wkblzmn/Cadence/firmware/cadence_cam/cadence_cam.ino

// ─────────────────────────────────────────────────────────────────────────
//  Cadence — camera board firmware
//  Target : ESP32-S3-CAM N16R8 + OV3660
//  Role   : put an MJPEG stream on the LAN, serve the page that watches it,
//           and hold the session state that decides when it records.
//
//  This board does no vision work. A browser tab does — it loads /vision from
//  here, runs MediaPipe against the stream, and POSTs focus samples back for
//  relaying. Keeping inference off the S3 is the whole reason the vision tier
//  is a separate tier; on-device vision is parked in Argus, not built here.
//
//  There is no phone in the built design, despite what the original plan said:
//  the vision host is a browser on the desktop. What matters about that is
//  that nothing records unless a tab is open, which is why the hub's Home
//  screen has a pill that can say NO VIEWER.
//
//  Pin map confirmed on hardware by 07_bringup_camera: the layout the ESP32
//  core calls ESP32S3_EYE, which is also the generic S3-CAM layout. Sensor
//  reported PID 0x3660, a genuine OV3660.
//
//  Board settings — these DIFFER from the hub, which is an N8R2:
//    ESP32S3 Dev Module · 16MB flash · **OPI PSRAM** (octal, not quad)
//    USB CDC on Boot Disabled · flash over the UART port
//
//  Credentials live in secrets.h in this folder, kept out of git.
// ─────────────────────────────────────────────────────────────────────────

#include "esp_camera.h"
#include <WiFi.h>
#include <WebServer.h>
#include <ESPmDNS.h>
#include <HTTPClient.h>
#include <WiFiClientSecure.h>
#include "secrets.h"
#include "vision_page.h"
#include "usb_stream.h"
#include "espnow_sync.h"

// ═══════════════════════════════════════════════════ pins (07_bringup_camera)

#define PIN_PWDN  -1
#define PIN_RESET -1
#define PIN_XCLK  15
#define PIN_SIOD   4
#define PIN_SIOC   5

#define PIN_D7    16
#define PIN_D6    17
#define PIN_D5    18
#define PIN_D4    12
#define PIN_D3    10
#define PIN_D2     8
#define PIN_D1     9
#define PIN_D0    11

#define PIN_VSYNC  6
#define PIN_HREF   7
#define PIN_PCLK  13

// Two servers on purpose.
//
// WebServer handles one client at a time and a streaming handler never
// returns while its viewer stays connected — so serving MJPEG from port 80
// makes the board deaf to every other request, including its own status
// page. A stale browser tab then locks everything out until a power cycle.
// Espressif's own example splits the ports for exactly this reason.
//
// Port 80: control. Always answers.
// Port 81: MJPEG, driven by its own task.
// The focus relay does a TLS handshake from inside a WebServer handler, which
// runs on the Arduino loop task. That handshake wants roughly 6 KB of stack
// and the default loop task has 8 KB — too close to rely on, and a stack
// overflow here would look like a random reboot whenever a sample is posted.
SET_LOOP_TASK_STACK_SIZE(16 * 1024);

WebServer  server(80);
WiFiServer streamServer(81);

// The single active viewer. A new connection displaces the old one rather
// than being refused: the common case is moving from the laptop to the phone,
// and being told "busy" by a tab you already closed is useless.
WiFiClient streamClient;

volatile uint32_t framesSent = 0;
volatile uint32_t lastFrameMs = 0;

// ═══════════════════════════════════════════════════ camera

// The live config is kept so the camera can be torn down and brought back up
// at a different frame size. esp_camera_init() allocates the frame buffers
// from this, which is exactly why a resolution change cannot be a simple
// set_framesize() call — see camRestart().
camera_config_t camCfg = {};

// Held around every use of a frame buffer. A reconfigure frees the buffers a
// streaming frame may still be writing into, so the two must never overlap.
SemaphoreHandle_t camLock = nullptr;

static void camConfigure(framesize_t fs) {
  camera_config_t &cfg = camCfg;
  cfg.pin_pwdn     = PIN_PWDN;
  cfg.pin_reset    = PIN_RESET;
  cfg.pin_xclk     = PIN_XCLK;
  cfg.pin_sccb_sda = PIN_SIOD;
  cfg.pin_sccb_scl = PIN_SIOC;
  cfg.pin_d7 = PIN_D7; cfg.pin_d6 = PIN_D6; cfg.pin_d5 = PIN_D5; cfg.pin_d4 = PIN_D4;
  cfg.pin_d3 = PIN_D3; cfg.pin_d2 = PIN_D2; cfg.pin_d1 = PIN_D1; cfg.pin_d0 = PIN_D0;
  cfg.pin_vsync = PIN_VSYNC;
  cfg.pin_href  = PIN_HREF;
  cfg.pin_pclk  = PIN_PCLK;

  cfg.xclk_freq_hz = 20000000;
  cfg.ledc_timer   = LEDC_TIMER_0;
  cfg.ledc_channel = LEDC_CHANNEL_0;

  // VGA, and deliberately not higher. MediaPipe's face pipeline downscales
  // its input to a few hundred pixels square before inference — a detector
  // crop feeding a landmark model — so resolution above roughly VGA is
  // discarded by the consumer before it is looked at. Measured on this board:
  // XGA is no faster and no more useful, it is just more bytes.
  //
  // Below VGA is worse, not better. QVGA and CIF measured ZERO frames: this
  // is a 3MP sensor and small sizes engage a scaler path that stalls. On this
  // part, asking for less is asking for slower.
  //
  // Quality 8 rather than 12: bandwidth peaked at 0.5 Mbps across every
  // configuration tested, so there is nothing to save by compressing harder,
  // and JPEG blocking costs exactly the fine structure a landmarker uses.
  cfg.pixel_format = PIXFORMAT_JPEG;
  cfg.frame_size   = fs;
  cfg.jpeg_quality = 8;
  cfg.fb_count     = 2;
  cfg.fb_location  = CAMERA_FB_IN_PSRAM;
  // LATEST, not WHEN_EMPTY: a viewer that falls behind should skip frames
  // rather than watch an ever-growing lag. Gaze data that is three seconds
  // late is worse than no data.
  cfg.grab_mode    = CAMERA_GRAB_LATEST;
}

static bool camStart() {
  esp_err_t err = esp_camera_init(&camCfg);
  if (err != ESP_OK) {
    Serial.printf("FATAL: camera init failed (0x%04x %s)\n", err, esp_err_to_name(err));
    return false;
  }

  sensor_t *s = esp_camera_sensor_get();
  Serial.printf("Camera  : ok, sensor PID 0x%04X\n", s ? s->id.PID : 0);

  // OV3660-specific correction, as in Espressif's own example: this sensor
  // comes up vertically flipped and over-saturated.
  if (s && s->id.PID == OV3660_PID) {
    s->set_vflip(s, 1);
    s->set_brightness(s, 1);
    s->set_saturation(s, -2);
  }

  // Favour frame rate over exposure from the start. This device lives on a
  // desk that is often dim — the light sensor next door has been reporting
  // single-digit lux — and left to itself the sensor lengthens exposure until
  // the stream drops to a few frames a second. Gain is the cheaper currency
  // here: the model wants a current frame more than a clean one. Reversible
  // at runtime with /set?fast=0.
  if (s) {
    // Low-light configuration, on by default, because a dim desk in the
    // evening is the case this device exists for. Verified on hardware: at
    // ~30 lux the auto loops give a black frame, and this gives a clearly
    // landmarkable face.
    //
    // The reason auto could never get there: aec_value and agc_gain are
    // manual-mode registers, ignored entirely while exposure_ctrl and
    // gain_ctrl are on auto. Raising ceilings and targets did nothing because
    // the sensor's own loop was overriding all of it.
    //
    // The trade is that manual exposure does not adapt, so a bright room will
    // blow this out. /set?night=0 hands both loops back to auto.
    s->set_gainceiling(s, GAINCEILING_128X);
    s->set_exposure_ctrl(s, 0);
    s->set_aec_value(s, 700);
    s->set_gain_ctrl(s, 0);
    s->set_agc_gain(s, 20);
    s->set_ae_level(s, 2);
    s->set_brightness(s, 2);
    s->set_raw_gma(s, 1);                  // measured on hardware: clearly better
  }

  // Deliberately NOT setting contrast, sharpness or lenc.
  //
  // Those three went in alongside raw_gma and the image went black. raw_gma
  // has since been shown on hardware to be the good one of the four — turning
  // it on visibly improves the picture — so the cause is among the remaining
  // three, most likely lenc: lens correction applies a per-module calibration
  // table, and the wrong table darkens the whole frame.
  //
  // Two rules earned here. Do not set anything at init that cannot also be
  // changed at runtime, or the first thing you cannot rule out is your own
  // default, invisible precisely because it is in every configuration. And do
  // not change four things at once, or you learn only that one of them was
  // wrong. All three remain available through /set.
  return true;
}

// A resolution change has to be a full teardown, not set_framesize().
//
// esp_camera_init() allocates the frame buffers for the size in the config.
// set_framesize() changes what the sensor emits but never touches those
// buffers, so going UP writes past the end of them — that is a heap overflow,
// and it wedged this board once already. Going down "fits" but produced zero
// frames in testing, because the DMA descriptors still describe the old
// geometry. Neither direction is safe.
//
// So: stop the world, free everything, allocate for the new size.
static bool camRestart(framesize_t fs) {
  xSemaphoreTake(camLock, portMAX_DELAY);
  esp_camera_deinit();
  camConfigure(fs);
  bool ok = camStart();
  xSemaphoreGive(camLock);
  Serial.printf("[CAM] reconfigured to framesize %d: %s\n", (int)fs, ok ? "ok" : "FAILED");
  return ok;
}

// ═══════════════════════════════════════════════════ http

// Every response carries CORS. This is not optional politeness: the vision
// page draws these frames into a canvas and hands the pixels to MediaPipe,
// and a cross-origin image without CORS taints the canvas so the pixels
// cannot be read back at all. The failure looks like a security error deep
// inside the model, nowhere near the <img> that caused it.
static void cors() {
  server.sendHeader("Access-Control-Allow-Origin", "*");
}

static void handleRoot() {
  cors();
  String ip = WiFi.localIP().toString();
  String body =
    "<!doctype html><meta name=viewport content='width=device-width,initial-scale=1'>"
    "<title>Cadence camera</title>"
    "<body style='font-family:system-ui;background:#0d0d0d;color:#eee;margin:0;padding:16px'>"
    "<h1 style='font-size:16px'>Cadence camera</h1>"
    "<p style='color:#999;font-size:13px'>Stream on port 81 &middot; "
    "single frame at <code>/jpg</code> &middot; <a style='color:#3987e5' href='/status'>status</a></p>"
    "<img src='http://" + ip + ":81/stream' style='max-width:100%;border-radius:8px'>"
    "<p style='color:#666;font-size:12px'>http://" + ip + ":81/stream<br>"
    "Only one viewer at a time — opening it somewhere else takes it over.</p>"
    "</body>";
  server.send(200, "text/html", body);
}

static void handleJpg() {
  xSemaphoreTake(camLock, portMAX_DELAY);
  camera_fb_t *fb = esp_camera_fb_get();
  if (!fb) {
    xSemaphoreGive(camLock);
    server.send(503, "text/plain", "capture failed");
    return;
  }
  cors();
  server.setContentLength(fb->len);
  server.send(200, "image/jpeg", "");
  server.client().write(fb->buf, fb->len);
  esp_camera_fb_return(fb);
  xSemaphoreGive(camLock);
}

// Live tuning without a reflash. The stream exists to feed a model, and the
// right size for that is not the right size for looking at, so both need to
// be adjustable while it runs.
static void handleSet() {
  sensor_t *s = esp_camera_sensor_get();
  cors();
  if (!s) { server.send(500, "text/plain", "no sensor"); return; }

  if (server.hasArg("size")) {
    String v = server.arg("size");
    framesize_t fs;
    if      (v == "qqvga") fs = FRAMESIZE_QQVGA;   // 160x120
    else if (v == "qvga")  fs = FRAMESIZE_QVGA;    // 320x240
    else if (v == "cif")   fs = FRAMESIZE_CIF;     // 400x296
    else if (v == "vga")   fs = FRAMESIZE_VGA;     // 640x480
    else if (v == "svga")  fs = FRAMESIZE_SVGA;    // 800x600
    else if (v == "xga")   fs = FRAMESIZE_XGA;     // 1024x768
    else { server.send(400, "text/plain", "size: qqvga|qvga|cif|vga|svga|xga"); return; }

    // Full restart, not set_framesize — the buffers must be reallocated.
    if (!camRestart(fs)) {
      server.send(500, "text/plain", "camera failed to restart at that size");
      return;
    }
    s = esp_camera_sensor_get();     // the old handle is gone after deinit
    if (!s) { server.send(500, "text/plain", "no sensor after restart"); return; }
  }

  if (server.hasArg("q")) {
    int q = server.arg("q").toInt();
    if (q < 4 || q > 63) { server.send(400, "text/plain", "q: 4-63, lower is better"); return; }
    s->set_quality(s, q);
  }

  // Low-light frame rate. This is the control that actually matters on a
  // desk at night: with auto-exposure free to lengthen the exposure, the
  // sensor buys brightness with time and the frame rate collapses — a few
  // lux gives a few fps, which reads as "the stream is laggy" and is in fact
  // the sensor doing its job.
  //
  // fast=1 turns off aec2 (the extended night-mode exposure) and raises the
  // gain ceiling, so the sensor buys brightness with gain instead. Noisier
  // and faster. For gaze and head pose that is the right trade — the model
  // needs a current frame far more than a clean one.
  if (server.hasArg("fast")) {
    bool fast = server.arg("fast") != "0";
    s->set_aec2(s, fast ? 0 : 1);
    s->set_gainceiling(s, fast ? GAINCEILING_32X : GAINCEILING_2X);
    s->set_gain_ctrl(s, 1);        // leave AGC on to use that headroom
    s->set_exposure_ctrl(s, 1);
  }

  // Brightness without spending time. ae_level moves the auto-exposure
  // *target*, and with night mode off and a high gain ceiling the sensor
  // reaches that target using gain — so the picture brightens and the frame
  // rate does not drop. This is the knob to reach for first when the image is
  // dim; raising exposure directly is what made it slow in the first place.
  if (server.hasArg("ae")) {
    int v = server.arg("ae").toInt();
    if (v < -2 || v > 2) { server.send(400, "text/plain", "ae: -2..2"); return; }
    s->set_ae_level(s, v);
  }

  if (server.hasArg("bright")) {
    int v = server.arg("bright").toInt();
    if (v < -2 || v > 2) { server.send(400, "text/plain", "bright: -2..2"); return; }
    s->set_brightness(s, v);
  }

  if (server.hasArg("contrast")) {
    int v = server.arg("contrast").toInt();
    if (v < -2 || v > 2) { server.send(400, "text/plain", "contrast: -2..2"); return; }
    s->set_contrast(s, v);
  }

  if (server.hasArg("sharpness")) {
    int v = server.arg("sharpness").toInt();
    if (v < -2 || v > 2) { server.send(400, "text/plain", "sharpness: -2..2"); return; }
    s->set_sharpness(s, v);
  }

  // Denoise cleans up the noise that high gain introduces — and takes fine
  // detail with it. On a face that detail is the eye and mouth landmarks, so
  // less is usually better here than the sensor's default.
  if (server.hasArg("denoise")) {
    int v = server.arg("denoise").toInt();
    if (v < 0 || v > 8) { server.send(400, "text/plain", "denoise: 0..8"); return; }
    s->set_denoise(s, v);
  }

  // Lens correction. This board's optics darken the corners noticeably, and
  // uneven brightness across the frame is worse than uniform dimness for a
  // model trying to find a face near an edge.
  if (server.hasArg("lenc")) {
    s->set_lenc(s, server.arg("lenc") != "0");
  }

  // Gamma on the raw data.
  if (server.hasArg("gma")) {
    s->set_raw_gma(s, server.arg("gma") != "0");
  }

  // Manual exposure and gain.
  //
  // These are the controls that matter in a dim room, and the reason nothing
  // worked earlier: aec_value and agc_gain are MANUAL-mode registers. They do
  // nothing while exposure_ctrl and gain_ctrl are left on auto, which is how
  // they sat at 490 and 2 through every change — not stale readings, just
  // registers that were never enabled.
  //
  // exposure: 0-1200, higher is longer (and slower). auto to hand it back.
  // gain:     0-30,   higher is brighter and noisier. auto to hand it back.
  if (server.hasArg("exposure")) {
    String v = server.arg("exposure");
    if (v == "auto") {
      s->set_exposure_ctrl(s, 1);
    } else {
      int e = v.toInt();
      if (e < 0 || e > 1200) { server.send(400, "text/plain", "exposure: 0-1200 or auto"); return; }
      s->set_exposure_ctrl(s, 0);
      s->set_aec_value(s, e);
    }
  }

  if (server.hasArg("gain")) {
    String v = server.arg("gain");
    if (v == "auto") {
      s->set_gain_ctrl(s, 1);
    } else {
      int g = v.toInt();
      if (g < 0 || g > 30) { server.send(400, "text/plain", "gain: 0-30 or auto"); return; }
      s->set_gain_ctrl(s, 0);
      s->set_agc_gain(s, g);
    }
  }

  // A documented low-light configuration for this sensor family, applied as
  // one unit. Manual exposure and manual gain, both high — it trades the
  // ability to adapt to changing light for actually being able to see in a
  // dim room, which is the right way round for a desk that does not change.
  if (server.hasArg("night")) {
    bool on = server.arg("night") != "0";
    if (on) {
      s->set_gainceiling(s, GAINCEILING_128X);
      s->set_exposure_ctrl(s, 0);
      s->set_aec_value(s, 700);
      s->set_gain_ctrl(s, 0);
      s->set_agc_gain(s, 20);
      s->set_ae_level(s, 2);
      s->set_brightness(s, 2);
    } else {
      s->set_exposure_ctrl(s, 1);
      s->set_gain_ctrl(s, 1);
      s->set_gainceiling(s, GAINCEILING_2X);
      s->set_ae_level(s, 0);
      s->set_brightness(s, 0);
    }
  }

  // Raising this lets AGC buy more brightness with gain. Costs noise, not fps.
  if (server.hasArg("gainceiling")) {
    int v = server.arg("gainceiling").toInt();
    gainceiling_t g;
    switch (v) {
      case 2:   g = GAINCEILING_2X;   break;
      case 4:   g = GAINCEILING_4X;   break;
      case 8:   g = GAINCEILING_8X;   break;
      case 16:  g = GAINCEILING_16X;  break;
      case 32:  g = GAINCEILING_32X;  break;
      case 64:  g = GAINCEILING_64X;  break;
      case 128: g = GAINCEILING_128X; break;
      default: server.send(400, "text/plain", "gainceiling: 2|4|8|16|32|64|128"); return;
    }
    s->set_gainceiling(s, g);
    s->set_gain_ctrl(s, 1);
  }

  server.send(200, "text/plain", "ok");
}

// ── vision page and the focus relay ──────────────────────────────────────

// One client of each kind, shared by every outbound request. A second
// WiFiClientSecure means a second mbedTLS context, and the handshake is
// already the largest thing this board allocates.
//
// Certificate validation is skipped — the same documented deviation the hub
// makes: pinning a CA bundle costs flash and needs rotating when the CA does.
static WiFiClientSecure tlsClient;
static WiFiClient       plainClient;

// ── the relay queue ──────────────────────────────────────────────────────
//
// A WebServer handler must never block. The first version did the TLS
// handshake to the backend inside handleFocus, which runs on the loop task —
// so while that handshake sat there, port 80 answered nothing at all: not
// /vision, not /status. The stream kept running only because it has its own
// task. Meanwhile the page posted again every 2 s and the board never
// recovered.
//
// So the handler queues and returns, and a task does the network. This is the
// same split the hub already makes for exactly the same reason, and the
// comment there says it plainly: HTTPClient blocks, which is why it is not
// allowed anywhere near loop().

#define RELAY_QUEUE    8
#define RELAY_BODY_MAX 640

struct RelayItem { char body[RELAY_BODY_MAX]; };
static RelayItem relayQ[RELAY_QUEUE];
static uint8_t relayHead = 0, relayCount = 0;
static SemaphoreHandle_t relayLock = nullptr;

volatile uint32_t relaySent = 0, relayDropped = 0;
volatile int relayLastStatus = 0;

static bool relayPush(const String &body) {
  if (body.length() >= RELAY_BODY_MAX) return false;
  xSemaphoreTake(relayLock, portMAX_DELAY);
  if (relayCount == RELAY_QUEUE) {          // drop oldest, keep the newest
    relayHead = (relayHead + 1) % RELAY_QUEUE;
    relayCount--;
    relayDropped++;
  }
  RelayItem &it = relayQ[(relayHead + relayCount) % RELAY_QUEUE];
  snprintf(it.body, RELAY_BODY_MAX, "%s", body.c_str());
  relayCount++;
  xSemaphoreGive(relayLock);
  return true;
}

static bool httpBegin(HTTPClient &http, const String &url) {
  bool opened;
  if (url.startsWith("https://")) {
    tlsClient.setInsecure();
    tlsClient.setTimeout(10);
    opened = http.begin(tlsClient, url);
  } else {
    opened = http.begin(plainClient, url);
  }
  if (!opened) return false;
  http.setConnectTimeout(5000);
  http.setTimeout(10000);
  return true;
}

// ── session gating ───────────────────────────────────────────────────────
//
// The hub owns the session; this board only remembers what it was last told.
// The hub cannot address a browser tab and the tab cannot see a button on the
// hub, so the state lands here — the one place both of them can reach — and
// the vision page asks a single question: should I be sampling right now?
//
// Expiry is as load-bearing as the state itself. If the hub loses power
// mid-session nothing would ever clear "running": the page would sample all
// night and focus_islands() would report one unbroken run that never
// happened, which is the exact failure its sample-gap guard exists to
// prevent. So the hub re-asserts while a session lives, and anything this
// board stops hearing about decays back to idle on its own.
//
// The TTL is three times the hub's re-assert interval — long enough that one
// lost packet is not a dropped session, short enough that a dead hub costs a
// minute and a half rather than an evening.

#define SESSION_TTL_MS 90000UL

static volatile uint8_t  sessionState   = 0;   // 0 idle · 1 running · 2 paused
static volatile uint32_t sessionHeardAt = 0;

static const char *sessionName(uint8_t s) {
  return s == 1 ? "running" : s == 2 ? "paused" : "idle";
}

// Applies a session state that arrived over ESP-NOW.
//
// Identical to what handleSession() does with ?state=, and deliberately so:
// the two are the same fact arriving by different roads, and the TTL refresh
// has to happen on both or a session held up only by radio packets would
// expire after ninety seconds.
// The camera implements this one; the status callback is the hub's job.
void cadenceNowOnCamStatus(uint8_t, uint8_t) {}

void cadenceNowOnSession(uint8_t state) {
  uint8_t was = sessionState;
  sessionHeardAt = millis();     // timestamp before state; see handleSession()
  sessionState   = state;

  // Tell the PC down the cable. Over USB there is no /session to poll, so this
  // is the only way the button on the desk reaches the app. Announced on change
  // only, and not suppressed while streaming: a text line lands inside at most
  // one frame, which fails its CRC and is dropped, and losing one frame out of
  // a session is a fair price for the press being acted on immediately.
  if (state != was) Serial.printf("#SESSION %s\n", sessionName(state));
}

// The state with the TTL applied. Every reader goes through this rather than
// touching sessionState, so a stale "running" cannot be observed anywhere.
static uint8_t sessionNow() {
  uint8_t s = sessionState;
  if (s != 0 && millis() - sessionHeardAt > SESSION_TTL_MS) return 0;
  return s;
}

// GET /session            — the vision page asking what it should be doing
// GET /session?state=...  — the hub telling this board what happened
//
// Unauthenticated, exactly like /set. This is a LAN-only control surface on a
// board that already serves its camera to the whole LAN, so a check here
// would guard nothing that is not already open. Said plainly rather than
// implied, because the relay next door goes to some trouble to keep the API
// token off this page and the difference between the two is worth seeing.
//
// `viewer` reports whether anything is pulling the stream, which is the
// closest this board can get to knowing the vision page is open — the page is
// the only thing that connects to it.
static void handleSession() {
  if (server.hasArg("state")) {
    String want = server.arg("state");
    uint8_t v = want == "running" ? 1 : want == "paused" ? 2
              : want == "idle"    ? 0 : 255;
    if (v == 255) {
      cors();
      server.send(400, "application/json",
                  "{\"error\":\"state must be running, paused or idle\"}");
      return;
    }
    // Ordering matters: the timestamp has to land before the state, or a
    // reader between the two lines sees "running" carrying the previous
    // heartbeat's age and expires a session that just started.
    sessionHeardAt = millis();
    sessionState   = v;
  }

  uint8_t s = sessionNow();
  char buf[160];
  snprintf(buf, sizeof(buf),
           "{\"state\":\"%s\",\"viewer\":%s,\"heard_s\":%lu}",
           sessionName(s),
           (streamClient && streamClient.connected()) ? "true" : "false",
           (unsigned long)((millis() - sessionHeardAt) / 1000));
  cors();
  server.send(200, "application/json", buf);
}

static void handleVision() {
  cors();
  server.send_P(200, "text/html", VISION_PAGE);
}

// The browser posts the exact body /api/ingest/focus expects; this attaches
// the bearer token and forwards it verbatim. No JSON parsing here on purpose
// — the backend already validates every field, and duplicating those rules in
// firmware would give two places to disagree.
//
// The point of the relay is that the token stays in firmware. A page served
// to the LAN cannot hold it, and this is the smallest thing that keeps it out
// of one. The trade is that anything on the LAN can post focus samples
// through this board — acceptable for a device whose dashboard is already
// public, and worth revisiting if that ever changes.
static void handleFocus() {
  cors();
  if (server.method() == HTTP_OPTIONS) {
    server.sendHeader("Access-Control-Allow-Methods", "POST, OPTIONS");
    server.sendHeader("Access-Control-Allow-Headers", "Content-Type");
    server.send(204);
    return;
  }

  String body = server.arg("plain");
  if (body.length() == 0 || body.length() > 4096) {
    server.send(400, "text/plain", "empty or oversized body");
    return;
  }

  // The page sends only its samples; device identity is injected here.
  //
  // It belongs with the token, in firmware — a page served to the LAN should
  // not be the thing that decides which device a sample is attributed to, and
  // hardcoding it in two places is how they drift apart. Splicing it onto the
  // front is a string operation, not a parse: the backend still validates
  // every field, and firmware still holds no opinion about the schema.
  if (body.startsWith("{")) {
    body = String("{\"device_id\":\"") + DEVICE_ID + "\"," + body.substring(1);
  } else {
    server.send(400, "text/plain", "expected a JSON object");
    return;
  }

  // Queue and return. The upstream POST happens on relayTask; blocking here
  // takes the whole control server down with it.
  if (!relayPush(body)) {
    server.send(413, "application/json", "{\"error\":\"body too large\"}");
    return;
  }
  server.send(202, "application/json", "{\"queued\":true}");
}

// Drains the queue. Runs on its own task with a stack big enough for a TLS
// handshake — roughly 6 KB of it — which is the other half of why this cannot
// live on the loop task.
static void relayTask(void *) {
  for (;;) {
    bool have = false;
    static char body[RELAY_BODY_MAX];

    xSemaphoreTake(relayLock, portMAX_DELAY);
    if (relayCount > 0) {
      memcpy(body, relayQ[relayHead].body, RELAY_BODY_MAX);
      have = true;
    }
    xSemaphoreGive(relayLock);

    if (!have) { vTaskDelay(pdMS_TO_TICKS(200)); continue; }

    String url = String(API_BASE) + "/api/ingest/focus";
    HTTPClient http;
    int status = -1;
    if (httpBegin(http, url)) {
      http.addHeader("Content-Type", "application/json");
      http.addHeader("Authorization", "Bearer " API_TOKEN);
      status = http.POST(String(body));
      if (status > 0 && (status < 200 || status >= 300)) {
        Serial.printf("[FOCUS] %d %s\n", status, http.getString().c_str());
      }
      http.end();
    }
    relayLastStatus = status;

    // 2xx accepted, 4xx is the server rejecting the payload itself and
    // retrying cannot fix that. Only a 5xx or a transport failure is worth
    // keeping — same policy the hub applies to its event queue.
    bool consume = (status >= 200 && status < 500);
    if (consume) {
      xSemaphoreTake(relayLock, portMAX_DELAY);
      if (relayCount > 0) { relayHead = (relayHead + 1) % RELAY_QUEUE; relayCount--; }
      xSemaphoreGive(relayLock);
      if (status < 300) relaySent++;
    } else {
      Serial.printf("[FOCUS] upstream failed (%d), will retry\n", status);
      vTaskDelay(pdMS_TO_TICKS(3000));
    }
    vTaskDelay(pdMS_TO_TICKS(50));
  }
}

static void handleStatus() {
  sensor_t *s = esp_camera_sensor_get();
  char buf[420];
  snprintf(buf, sizeof(buf),
           "{\"rssi\":%d,\"ip\":\"%s\",\"framesize\":%d,\"quality\":%d,"
           "\"ae_level\":%d,\"brightness\":%d,\"agc_gain\":%d,\"aec_value\":%d,"
           "\"frames_sent\":%lu,\"viewer\":%s,\"uptime_s\":%lu,"
           "\"relay_sent\":%lu,\"relay_dropped\":%lu,\"relay_status\":%d,"
           "\"session\":\"%s\"}",
           WiFi.RSSI(), WiFi.localIP().toString().c_str(),
           s ? (int)s->status.framesize : -1,
           s ? (int)s->status.quality : -1,
           s ? (int)s->status.ae_level : 0,
           s ? (int)s->status.brightness : 0,
           s ? (int)s->status.agc_gain : 0,
           s ? (int)s->status.aec_value : 0,
           (unsigned long)framesSent,
           (streamClient && streamClient.connected()) ? "true" : "false",
           (unsigned long)(millis() / 1000),
           (unsigned long)relaySent, (unsigned long)relayDropped,
           relayLastStatus,
           sessionName(sessionNow()));
  cors();
  server.send(200, "application/json", buf);
}

// ── the stream task ──────────────────────────────────────────────────────
//
// multipart/x-mixed-replace — the browser replaces the image in place for
// every part, which is what makes an <img> behave like video.

static void sendStreamHeader(WiFiClient &c) {
  c.print("HTTP/1.1 200 OK\r\n"
          "Access-Control-Allow-Origin: *\r\n"
          "Cache-Control: no-store\r\n"
          "Connection: close\r\n"
          "Content-Type: multipart/x-mixed-replace; boundary=cadenceframe\r\n"
          "\r\n");
}

static void streamTask(void *) {
  streamServer.begin();
  streamServer.setNoDelay(true);

  for (;;) {
    WiFiClient incoming = streamServer.available();
    if (incoming) {
      // Drain the request line and headers. Without this the request sits in
      // the socket buffer and the first frame is appended to it.
      uint32_t t0 = millis();
      while (incoming.connected() && millis() - t0 < 1000) {
        String line = incoming.readStringUntil('\n');
        if (line.length() <= 1) break;          // blank line ends the headers
      }

      if (streamClient && streamClient.connected()) streamClient.stop();
      streamClient = incoming;
      streamClient.setNoDelay(true);
      sendStreamHeader(streamClient);
      USBLOG("[STREAM] viewer attached");
    }

    if (!streamClient || !streamClient.connected()) {
      vTaskDelay(pdMS_TO_TICKS(20));
      continue;
    }

    // Lock spans the whole frame: the buffer stays owned by the driver until
    // it is returned, and a reconfigure in that window would free it mid-write.
    xSemaphoreTake(camLock, portMAX_DELAY);
    camera_fb_t *fb = esp_camera_fb_get();
    if (!fb) {
      xSemaphoreGive(camLock);
      vTaskDelay(pdMS_TO_TICKS(20));
      continue;
    }

    streamClient.printf("--cadenceframe\r\n"
                        "Content-Type: image/jpeg\r\n"
                        "Content-Length: %u\r\n\r\n",
                        (unsigned)fb->len);
    size_t sent = streamClient.write(fb->buf, fb->len);
    streamClient.print("\r\n");

    bool short_write = (sent != fb->len);
    esp_camera_fb_return(fb);
    xSemaphoreGive(camLock);

    if (short_write) {
      // The viewer went away mid-frame. Drop it rather than keep grabbing
      // frames for a socket nobody is reading.
      USBLOG("[STREAM] viewer left");
      streamClient.stop();
      continue;
    }

    framesSent++;
    lastFrameMs = millis();
    vTaskDelay(1);      // yield to the Wi-Fi stack
  }
}

// ═══════════════════════════════════════════════════ setup / loop

void setup() {
  // Fast, because this link now carries video and not just a boot log. The TX
  // buffer has to be sized before the port opens; see usbStreamPrepare().
  usbStreamPrepare();
  Serial.begin(SERIAL_BAUD);
  delay(600);
  Serial.println("\n\n=== Cadence camera ===");

  if (!psramFound()) {
    Serial.println("FATAL: no PSRAM. N16R8 needs the OPI PSRAM board setting.");
    while (true) delay(1000);
  }
  camLock = xSemaphoreCreateMutex();
  if (!camLock) {
    Serial.println("FATAL: could not create the camera mutex.");
    while (true) delay(1000);
  }

  camConfigure(FRAMESIZE_VGA);
  if (!camStart()) {
    while (true) delay(1000);
  }

  WiFi.mode(WIFI_STA);
  WiFi.setSleep(false);          // sleep adds latency and stutters the stream
  WiFi.begin(WIFI_SSID, WIFI_PASS);
  Serial.printf("Wi-Fi   : connecting to \"%s\"", WIFI_SSID);

  uint32_t start = millis();
  while (WiFi.status() != WL_CONNECTED && millis() - start < 20000) {
    delay(300);
    Serial.print(".");
  }
  Serial.println();

  // Not fatal any more. This used to halt forever, which was defensible when
  // Wi-Fi was the only way to reach the board and a silent brick was at least
  // honest about it. It is indefensible now: the USB link works with no network
  // at all, and this device has to run in a lecture hall on a network whose
  // credentials are not compiled in and may not be joinable by an ESP32 at all.
  // Halting here would strand the board before it ever reached usbTask.
  if (WiFi.status() != WL_CONNECTED) {
    Serial.println("Wi-Fi   : NOT CONNECTED — continuing on USB only.");
    Serial.println("          The stream, /set and the relay are unavailable;");
    Serial.println("          frames and settings still work over the cable.");
  } else {

    // A DHCP lease moves. mDNS gives the phone a name that does not, so the
    // vision page does not need re-pointing every time the router reshuffles.
    if (MDNS.begin(CAM_HOSTNAME)) {
      MDNS.addService("http", "tcp", 80);
      Serial.printf("mDNS    : http://%s.local/stream\n", CAM_HOSTNAME);
    }

    server.on("/", handleRoot);
    server.on("/jpg", handleJpg);
    server.on("/status", handleStatus);
    server.on("/set", handleSet);
    server.on("/vision", handleVision);
    server.on("/session", handleSession);
    server.on("/focus", HTTP_POST, handleFocus);
    server.on("/focus", HTTP_OPTIONS, handleFocus);
    server.begin();

    // Own task so a connected viewer can never block the control server.
    xTaskCreatePinnedToCore(streamTask, "stream", 4096, nullptr, 1, nullptr, 1);

    // Same reasoning for the upstream POST: TLS blocks, and the handler that
    // queues it must not. 12 KB because the handshake alone wants about 6.
    relayLock = xSemaphoreCreateMutex();
    if (!relayLock) {
      Serial.println("FATAL: could not create the relay mutex.");
      while (true) delay(1000);
    }
    xTaskCreatePinnedToCore(relayTask, "relay", 12288, nullptr, 1, nullptr, 0);

    String ip = WiFi.localIP().toString();
    Serial.printf("Wi-Fi   : up, ip=%s rssi=%d\n", ip.c_str(), WiFi.RSSI());
    Serial.printf("Stream  : http://%s:81/stream\n", ip.c_str());
    Serial.printf("Preview : http://%s/\n", ip.c_str());
    Serial.printf("Status  : http://%s/status\n", ip.c_str());
    Serial.printf("Tune    : http://%s/set?size=qvga&q=15\n", ip.c_str());
    Serial.printf("Vision  : http://%s/vision\n", ip.c_str());
  }

  // Outside the Wi-Fi branch entirely. This is the whole point of the change:
  // the cable needs no network, no DHCP lease, no mDNS and no access point,
  // so starting it must not be conditional on any of them.
  // Before usbStreamBegin so its banner is the last line of the boot log.
  // Runs whether or not Wi-Fi came up: not needing an access point is the
  // entire reason this is here rather than another HTTP endpoint.
  cadenceNowBegin(true);

  usbStreamBegin();
  Serial.printf("USB     : %ld baud, send C1 to start frames\n", (long)SERIAL_BAUD);
}

void loop() {
  server.handleClient();

  // Tell the hub we are alive, and whether a USB host is actually pulling
  // frames. This replaces what the hub used to read out of the HTTP response
  // to its own push — a reply that does not exist when there is no network.
  // Two seconds, against the ten-second staleness window on the hub side.
  static uint32_t lastNowStatus = 0;
  if (millis() - lastNowStatus >= 2000UL) {
    lastNowStatus = millis();
    cadenceNowSend(CADENCE_NOW_STATUS, sessionNow(),
                   usbStreaming ? CADENCE_NOW_F_STREAMING : 0);
  }

  static uint32_t lastCheck = 0;
  static uint8_t  wifiFails = 0;
  if (millis() - lastCheck > 10000) {
    lastCheck = millis();
    if (WiFi.status() == WL_CONNECTED) {
      wifiFails = 0;
    } else if (wifiFails < CADENCE_NOW_GIVEUP) {
      // Alternate between the configured networks rather than retrying one.
      // The second is meant to be a phone hotspot, which is the only kind of
      // network an ESP32 can join away from home.
      WiFi.begin(cadenceSsid(wifiFails), cadencePass(wifiFails));
      wifiFails++;
      USBLOG("[WIFI] link lost, trying the next network");
    } else {
      // Nothing to join. Stop scanning and leave the radio where ESP-NOW can
      // use it; the cable does not need a network and neither does the hub link.
      cadenceNowLockChannel();
    }
  }
}
