wkblzmn/Cadence/(commit log)

2026-08-12 Fix ingest/stats bugs and build the dashboard UI
    Three defects, all of which reported success while losing data:
    - POST /api/todos interpolated a nested sql`` fragment for the default
    position. The neon driver binds interpolated values as parameters rather
    than composing them, so the fragment was sent as an object and rejected by
    the int column — every create without an explicit position 500'd.
    - GET /api/stats/daily returned 0 for every day. The driver parses a bare
    `date` into a JS Date in the process timezone, so String(day).slice(0,10)
    produced "Wed Aug 12" and matched no key. Days now stay text end to end.
    - POST /api/ingest/readings answered 201 whether or not a row was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
2026-08-13 Add task CRUD and reorder to the dashboard
    Closes the Phase 3 "task view (CRUD + reorder)" item. Create, rename,
    complete, restore, delete, and move up/down, all from the dashboard.
    Implemented as server actions rather than fetches to /api/todos. The route
    handlers authenticate with DEVICE_TOKEN because they exist for the hub;
    putting that token in the browser to drive the UI would publish it to every
    visitor. Actions run server-side against the same DATABASE_URL, which is the
    access model schema.sql part 3 already describes — the browser never talks to
    Postgres. The routes are unchanged and still serve the hub.
    Every control is its own form bound to an action, so the whole view works
    wi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
2026-08-13 Collapse the hub UI from five pages to three
    Builds the redesign approved 2026-08-10, which was gated on Wi-Fi + NTP
    landing first — the hero element of Home is a clock, and building the screen
    around a placeholder then rebuilding it is doing the work twice.
    Page 01 Home — everything ambient on one screen, so the common case needs no
    navigation: clock left, labelled timer right, environment row,
    face band, tasks remaining and a vision pill.
    Page 02 Tasks — unchanged.
    Page 03 Status & session — Wi-Fi, NTP, sensor health, backend state, session.
    Layout against the 240px panel: top strip 0..51, environment row 52..79, face
    band 82..174 (296x92 as speci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
    [cadence_hub.ino]
2026-08-13 Pull the todo list from the dashboard; 12-hour clock
    Closes the last Phase 3 item. The hub had been showing a hardcoded array
    while GET /api/todos was live the whole time — and the array was stale, still
    listing "Wi-Fi + NTP on the hub" and "POST readings to backend" as open.
    Fetch: every 60s, retrying every 5s until the first list lands so a boot does
    not wait out a whole interval. No Authorization header — that endpoint is
    unauthenticated by design, as the route itself documents.
    Concurrency: its own mutex, not evqLock. The list is written by netTask on
    core 0 and read by render() on core 1; coupling a 15fps render to the network
    drain would be contention for nothing.
    Stack: the sta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
2026-08-13 Add the wiring reference
    Hardware reference for the ESP32-S3 build, verified on the bench 2026-08-12.
    Supersedes §3 of the spec, which was written against a WROOM-32 whose GPIO
    numbering does not apply to the S3.
    Covers the master pin map, per-component wiring with the traps that cost time
    (the TFT's touch pins sit beside the real MOSI and SCK; the BH1750 keeps
    answering on the bus with VCC disconnected), the rebuild order, Arduino IDE
    board settings, and why the display library is LovyanGFX rather than TFT_eSPI.
2026-08-13 Add the I2C bring-up diagnostic
    firmware/bringup/ was an empty directory — untracked, so not in the repo at
    all — while WIRING.md's rebuild order and the bench log both point at these
    sketches as the thing that proves each stage before the next is added.
    This one answers the three questions a silent I2C part raises, in the order
    that stops you re-soldering a chip that was never powered:
    1. Is the module powered? Both modules pull up to their own VCC, so the
    line is driven down through the internal pulldown to see who wins. A
    powered pull-up holds it HIGH; an unpowered one cannot. That is a
    multimeter substitute, and it is reusable on any I2C part.
    2. Is anything on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
2026-08-13 Fix a misleading verdict in the I2C diagnostic
    The "other devices answer" branch fired whenever no Bosch part replied and
    the pull-ups were up — including when nothing answered at all. That is the
    isolation case, where the module under test is alone on the bus: its own
    pull-ups prove it has power, and its silence then means the chip is dead
    rather than mis-wired. Saying "other devices answer" there is exactly
    backwards, and it is the one run where the message decides whether you
    re-solder or buy a replacement.
    [01_bringup_i2c.ino]
2026-08-13 Add a theme toggle and make the dashboard usable on a phone
    Theme has three states, not two. globals.css was already built for it — no
    data-theme attribute means "follow the OS", and an explicit stamp wins in
    either direction — so a two-way switch would strand anyone who flipped it once
    with no way back to following their system.
    An inline script in layout.tsx applies the stored choice before first paint.
    Without it the page renders in the OS theme and snaps to the chosen one on
    hydration, which is a flash of the wrong colours on every navigation.
    The chart is now plain HTML and CSS rather than SVG. A viewBox scales its text
    along with its geometry, so the 11px axis labels came out aro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
2026-08-16 Support BMP280 + DHT22 as well as a BME280
    The BME280 that arrived was a BMP280 — chip ID 0x58, no humidity sensor on
    the die. The GYBMEP silkscreen reads BME/BMP280 for both parts and they are
    visually identical, so which one is fitted is not knowable until the chip ID
    is read at boot. Adafruit_BME280 refuses anything that is not 0x60, so a
    BMP280 needs its own driver rather than a flag.
    Detection order: BME280, else BMP280, then probe for a DHT22 only when
    humidity is still missing — a BME280 build pays nothing for the fallback,
    including its settling delay. Three source flags collapse into hasTemp /
    hasHumidity / hasPressure so the render and post paths never have to know
    which combi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
    [cadence_hub.ino]
2026-08-16 Guard focus_samples against duplicate batches
    The last ingest table with no dedupe index. Nothing writes to it yet, but the
    phone will batch-POST focus samples over a link that drops exactly like the
    hub's, and a retried batch without this quietly doubles every attention
    figure — the same failure the readings table was already given a guard for.
    The route now reports `inserted` alongside `received`. Answering 201
    identically whether or not rows landed is how a stalled writer stayed
    invisible on the readings route for an afternoon.
    Index applied to Neon.
2026-08-16 Add the camera bring-up probe
    First step of Phase 4. The board's module marking (ESP32-S3 N16R8) identifies
    the MCU, never the carrier, and the carrier is what decides the camera pins.
    Guessing fails silently — esp_camera_init() returns an error, or worse it
    succeeds and every frame is black.
    So it tries each known S3 layout in turn and reports which one actually
    brings the sensor up. The pin values are lifted verbatim from the maps the
    ESP32 core ships in CameraWebServer/camera_pins.h rather than written from
    memory.
    Two-stage check per candidate, because the two buses fail differently:
    initialising proves the SCCB control bus, but only capturing a real frame
    proves the parallel data bu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
    [07_bringup_camera.ino]
2026-08-16 Add the camera board firmware: MJPEG stream on the LAN
    Second Phase 4 step. This board does no vision work — it is a camera on the
    network. The phone runs MediaPipe against this stream and POSTs focus
    samples, which is the whole reason the vision tier is a separate tier;
    on-device inference is parked in Argus.
    Pin map is the one 07_bringup_camera confirmed on hardware (the layout the
    core calls ESP32S3_EYE), and the sensor reported PID 0x3660, a real OV3660,
    so the OV3660-specific vflip/brightness/saturation correction is applied.
    VGA rather than the sensor's full 3MP: face landmarking gains nothing from
    more pixels, and each one costs bandwidth on a shared link and decode time on
    the ph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
    [cadence_cam.ino]
2026-08-16 Move the camera stream off port 80 so one viewer cannot lock the board out
    WebServer serves one client at a time, and a streaming handler never returns
    while its viewer stays connected. Serving MJPEG from port 80 therefore made
    the board deaf to every other request — a second device could not connect,
    and neither could the status page. A browser tab left open on a laptop locked
    everything out until a power cycle, which is exactly what happened: the
    stream worked on the PC and the phone timed out.
    Control now stays on port 80 and the stream runs on port 81 from its own
    task, which is the same split Espressif's example uses and for the same
    reason.
    A new stream connection displaces the exi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
2026-08-16 Stop the sensor trading frame rate for exposure in a dim room
    Measured 3.8 fps at VGA with a -50 dBm link, which is not a bandwidth
    problem. The cause is the room: the BH1750 next to it has been reporting
    single-digit lux all evening, and with auto-exposure free to run, the sensor
    buys brightness with time. A few lux gives a few fps. The stream reads as
    laggy while the sensor is doing exactly what it was asked to.
    So ask for something else. aec2 — the extended night-mode exposure — is now
    off and the gain ceiling raised to 16x, so brightness comes from gain
    instead. Noisier, and current. For gaze and head pose that is the right
    trade: the model needs a recent frame far more than a clean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
    [cadence_cam.ino]
2026-08-16 Reallocate the frame buffers when the resolution changes
    /set?size= called set_framesize() and nothing else. That was wrong in both
    directions and I wedged the board proving it.
    esp_camera_init() allocates the frame buffers for the size in its config.
    set_framesize() changes what the sensor emits but never touches those
    buffers. Raising the size therefore writes past the end of the allocation — a
    heap overflow, which is what took the board down when a sweep stepped VGA up
    to SVGA. Lowering it "fits", but measured zero frames at QVGA and CIF,
    because the DMA descriptors still describe the old geometry. Neither
    direction is safe.
    A resolution change is now a full teardown: deinit, reconfig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
    [cadence_cam.ino]
2026-08-16 Buy brightness with gain instead of exposure time
    Trading exposure for frame rate fixed the lag and left the picture dim, which
    is the same trade seen from the other side. Gain is the currency that does
    not cost time, so spend more of it: gain ceiling raised to 32x, AGC left on
    to use the headroom, and ae_level pushed to +2 so auto-exposure aims at a
    brighter target and reaches it with gain rather than a longer exposure.
    ae_level is the knob to reach for when the image is dim. Raising exposure
    directly is what made the stream slow in the first place.
    All four are live-tunable now — ae, bright, contrast and gainceiling — so
    finding the right values is a URL edit rather than a reflash ea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
    [cadence_cam.ino]
2026-08-16 Add sharpness, denoise and lens correction
    Brightness came back but the picture stayed soft, which is a different
    problem: gain adds noise, JPEG smooths it, and the sensor's own denoise
    smooths what is left. On a face the detail being smoothed away is exactly the
    eye and mouth structure the landmarker needs.
    Contrast and sharpness now lift at init, since gain flattens an image as it
    brightens it. Lens correction is on because this board's optics darken the
    corners visibly, and uneven brightness across the frame is worse for a face
    detector than uniform dimness.
    sharpness, denoise and lenc are live-tunable alongside the rest, so the
    clarity trade can be found on the running board rather tha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
    [cadence_cam.ino]
2026-08-16 Settle on VGA q8 as the vision-tier default
    Picking the frame rate first, then the best image that fits it.
    5 fps is the target. Focus is a slow signal; what sets the floor is transient
    rejection, not responsiveness. A blink is 100-400 ms and a glance away is not
    distraction, so a sample every 2 s wants roughly ten frames to vote over.
    Above that is waste.
    VGA, and not higher. MediaPipe's face pipeline downscales to a few hundred
    pixels square before inference, so resolution beyond about VGA is discarded
    by the consumer before it is used. Measured here, XGA was no faster and no
    more useful — just more bytes. Below VGA is worse rather than cheaper: QVGA
    and CIF measured zero frames, becau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
2026-08-16 Stop setting gamma and friends at init; expose raw_gma
    The image went black after 0459b65, which added contrast, sharpness, lenc and
    raw_gma to init in one go. Neutralising every live control did not bring it
    back, and neither did a power cycle — because raw_gma was the only one of the
    four with no runtime control, so it survived every attempt to rule it out and
    was reapplied at every boot. Gamma applied wrongly crushes the image to black
    whatever the exposure does. A torch held against the lens still read as
    almost nothing, while the frame itself was correctly composed and in focus,
    which is what ruled out the ribbon, the optics and the aim.
    Init now sets only what was in place when the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
    [cadence_cam.ino]
2026-08-16 Enable raw_gma at init — it was the good one of the four
    Correction to the previous commit. raw_gma was blamed for the black image
    because it was the only one of four tweaks with no runtime control, so it
    could not be ruled out from a browser. Not being able to rule something out
    is not evidence against it.
    Enabling it on hardware, with the other three off, gives the best image of
    the session: bright, sharp, and clearly landmarkable. So gamma was helping
    throughout, and the cause is among contrast, sharpness and lenc — most likely
    lenc, since lens correction applies a per-module calibration table and the
    wrong table darkens the whole frame.
    raw_gma goes back into init, which no longer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
    [cadence_cam.ino]
2026-08-16 Add manual exposure and gain, and a documented night preset
    The reason none of the low-light tuning worked: aec_value and agc_gain are
    MANUAL-mode registers. They do nothing while exposure_ctrl and gain_ctrl are
    left on auto, which is exactly how they were left. That is why /status showed
    them pinned at 490 and 2 through every change — not stale cached readings, as
    previously claimed here, but registers that were never enabled. Every
    adjustment made all evening moved ceilings and targets while the sensor's own
    auto loop quietly ignored them.
    exposure= and gain= now switch those loops to manual and set the values.
    night=1 applies a configuration documented as working for this sensor famil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
2026-08-16 Default the camera to the low-light configuration
    Verified on hardware: at roughly 30 lux the auto exposure and gain loops
    produce a black frame, and this configuration produces a clearly landmarkable
    face — eyes, glasses and mouth all resolved. Noisy, which a face landmarker
    tolerates far better than darkness.
    On by default because a dim desk in the evening is the case this device
    exists for, not an edge case. The trade is that manual exposure does not
    adapt, so a bright room will blow it out; /set?night=0 hands both loops back
    to auto.
    [cadence_cam.ino]
2026-08-16 Add the vision page and a token-holding focus relay
    Phase 4's compute tier, in the browser rather than on the chip. ESP-DL is not
    in arduino-esp32 3.x, so on-device inference would mean adopting ESP-IDF for
    this board; and its face detector gives five keypoints where MediaPipe gives
    478 landmarks plus blendshape gaze. Distinguishing a screen from a phone is a
    small-angle problem, which is exactly where five keypoints would not separate.
    GET /vision is served from this board because the stream is HTTP on the LAN
    and the deployed dashboard is HTTPS — browsers refuse that mix, so the page
    cannot live on the dashboard. Same-scheme here, and an HTTP page may still
    call an HTTPS API; only the r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
    [cadence_cam.ino, vision_page.h]
2026-08-16 Fix the MediaPipe version pin and add gaze from blendshapes
    Two things research caught that testing would have found the slow way.
    The version pin was 0.10.14, which is not a published version of
    @mediapipe/tasks-vision at all — the CDN lists 1.0.1 as current. The import
    would have 404'd and the page died before any of its own code ran, showing
    nothing useful about why. Pinned to 1.0.1, confirmed against the CDN's own
    version list rather than assumed.
    Gaze now comes from the blendshapes the model already returns, alongside head
    pose. Head pose alone misses the case that matters most: glancing at a phone
    on the desk moves the eyes far more than the head, which is exactly the
    small-angle p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
    [vision_page.h]
2026-08-16 Add the camera board's own httpBegin, and grow the loop task stack
    Build fix. httpBegin was written for the hub; the relay called it from habit
    and the camera board never had one. It now has its own, sharing a single TLS
    and a single plain client so a second mbedTLS context is never allocated.
    Also raises the loop task stack to 16 KB. The relay performs a TLS handshake
    inside a WebServer handler, which runs on the loop task — and that handshake
    wants roughly 6 KB against a default of 8. That margin does not fail at build
    time; it fails as a reboot whenever a focus sample is posted, which is a
    miserable thing to trace back to stack depth.
    Compiled clean for the camera board: 54% flash, 18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
    [cadence_cam.ino]
2026-08-17 Keep the enclosure files out of git
    hardware/ holds the 3D-printable enclosure design and stays local by request.
    Nothing from it was ever tracked, so ignoring it is sufficient — no history
    to purge.
2026-08-17 Inject device_id into relayed focus samples
    The vision page posted {"samples":[...]} and the backend rejected it with 400:
    device_id is required and nothing was supplying it. Inference, landmarks and
    classification were all working — only the post failed.
    The relay adds it, rather than the page. Device identity belongs in firmware
    beside the token: a page served to the LAN should not decide which device a
    sample is attributed to, and hardcoding the id in two places is how they
    drift apart. It is spliced onto the front of the body as a string operation,
    not a parse — the backend still validates every field and the firmware still
    holds no opinion about the schema.
    DEVICE_ID must match th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
    [cadence_cam.ino]
2026-08-17 Queue relayed focus samples instead of blocking the loop task
    The relay did its TLS handshake inside a WebServer handler, which runs on the
    loop task. While that handshake sat there, port 80 answered nothing at all —
    not /vision, not /status — and the page posted again every 2 s, so the board
    never got out of it. Only the stream survived, because it has its own task.
    The hub's own firmware says this in a comment: HTTPClient blocks, which is
    exactly why it is not allowed anywhere near loop(). The same rule applies to a
    request handler, and I broke it.
    handleFocus now copies the body into an eight-slot queue and returns 202
    immediately; relayTask does the POST on its own core with a 12 K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
    [cadence_cam.ino]
2026-08-17 Batch focus samples, and show the measured tick rate
    Every post cost the board a TLS handshake, and one per 2 s window arrived
    faster than it could complete them: its queue backed up and dropped the
    oldest, losing roughly a third of samples — 11 stored against 15 due over a
    30 s run. Samples now accumulate in the page and upload every 10 s. The
    ingest route takes up to 500 per call and always did; it was built for this
    and then not used. A failed batch goes back to the front of the queue, so a
    transient error costs a delay rather than the data.
    Also shows the measured tick rate, which is useful while calibrating: it says
    what the loop is actually achieving rather than what it was asked fo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
    [vision_page.h]
2026-08-17 Add attention analytics to the dashboard
    Closes Phase 4's analytics item. focus_samples is a series of states a couple
    of seconds apart, but the interesting quantities are runs of them rather than
    counts: how long attention held unbroken, and how often it broke. So
    focus_islands() collapses consecutive same-state samples first.
    Two things break a run and both matter. The state changing is obvious. A gap
    in the samples is not: the vision page is a calibration tool rather than an
    always-on tracker, so it stops when its tab does, and without a gap guard a
    run would silently span the hours it was closed and report an unbroken
    four-hour focus that never happened.
    Seconds come from island spans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
2026-08-17 Arm the vision tier from the focus button, and rebuild Home
    The focus-timer button now starts and stops the camera's recording. The hub
    cannot address a browser tab, so it does not try: GET /session?state=... on the
    camera board sets the state, the /vision page polls it every 2 s, and recording
    follows. Sessions and focus samples finally describe the same stretch of time.
    Before this, the page sampled whenever a tab happened to be open, which is how
    a tab left open overnight became an unbroken four-hour focus.
    Both boards change in one commit on purpose. A new camera against an old hub
    sits at "idle" forever and records nothing at all, which looks exactly like a
    broken vision tier — so sp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
    [cadence_cam.ino, cadence_hub.ino, vision_page.h]
2026-08-17 Add GitLab's SAST and secret-detection pipeline
    Taken from the commit GitLab created when secret detection was enabled in its
    UI. Carried into this history deliberately rather than left on the remote: the
    push that follows replaces GitLab's initial commit outright, and a config that
    exists only in the commit being replaced would vanish without anything saying
    so.
    Secret detection is well aimed at this repo. Two boards and a dashboard each
    keep credentials in a gitignored file beside a tracked .example, and the only
    thing separating them is a line in .gitignore that is invisible in an editor.
    A scanner that fails the pipeline when a real token lands in a tracked file is
    a second pair of eyes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
2026-08-17 Drop the GitLab CI config
    Reverses the decision two commits ago to preserve it. The pipeline fails
    instantly on creation -- no jobs, no YAML error, finished_at equal to
    created_at -- and it failed the same way on GitLab's own initial commit, before
    any of this code existed. That is the shared-runner path never engaging, not
    anything here being wrong.
    It was never asked for. The file arrived from a checkbox in GitLab's
    project-creation flow, and the argument for keeping it was that secret
    detection suits a repo where credentials sit in gitignored files beside tracked
    .example twins. That argument still holds in principle and buys nothing in
    practice while the runners cannot start: all it pro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
2026-08-17 Rebuild Home a third time: your layout, with a hierarchy
    Two failed attempts are recorded here because they were opposite mistakes and
    both are instructive.
    The first kept every element at equal weight behind identical hairlines. All the
    information was present and none of it was findable -- a content inventory
    rather than a page, which is why it read as bland on hardware despite being
    dense. Density was never the problem; uniformity was.
    The second fixed the hierarchy by deleting most of the content: one hero, a
    bare sparkline, a two-line footer. It looked considerably better and answered a
    question nobody asked, because a desk companion that has dropped four of its
    five readings is a dif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
    [cadence_hub.ino]
2026-08-17 Fix the clipped text, and set the type in Old Standard and New Century
    The letters were being cut in half. Two causes, both mine.
    A u8g2 font's name is its CAP HEIGHT, not its box height. helvR08 occupies 13
    rows, helvR12 occupies 20, logisoso38 occupies 57. The layout was spaced by the
    names, so rows overlapped -- and because drawString with a two-argument
    setTextColor paints an opaque background, each row then erased the bottom of the
    one above it. The readings labels were being scrubbed by their own values, and
    "idle" was being scrubbed by the 39px-tall elapsed timer sitting under it.
    Worse than the bug: the audit that passed it. It hardcoded the font heights as
    the numbers in the names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
    [cadence_hub.ino]
2026-08-17 Replace the browser with a headless vision host
    The focus-timer button could not start tracking on its own. The camera board is
    an ESP32-S3 and cannot run the inference, so the classifier lived in a page at
    /vision -- which meant a browser tab had to already be open before the button on
    the desk did anything. Nothing about that is discoverable from the chair, and
    "open a tab before you start working" is a chore, not a design.
    vision/cadence_vision.py does the same job as a background process: polls the
    board for the session state, pulls frames while a session is running, classifies
    with MediaPipe, and posts batches to the board's /focus relay. It still goes
    through the relay rather than str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
    [vision_page.h]
2026-08-17 Make the vision host survive being left alone
    Three defects, all of which only appear once nobody is watching it.
    The stream was opened when recording started and closed when it stopped, so
    between sessions the board saw no viewer and the hub's pill read "no viewer" --
    which says "your camera is broken" when the truth was "a host is attached and
    waiting for the button". The browser tab this replaced held that connection
    open the whole time it was open, so the indicator used to mean "a host is
    attached"; moving to a headless host silently changed what it meant. The
    connection is now opened once for the life of the process and read continuously,
    and the comment says why so it does not get opt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
2026-08-18 Log what the host classifies, not just that it is running
    Under pythonw there is no console, so every print() in the hot path went
    nowhere. The process could be classifying correctly for hours and host.log would
    show only the startup line -- which is indistinguishable from a host that
    connected and then did nothing, and that is exactly the state this was being
    blamed for.
    Sample states, post results and post failures now go through log(). Verified end
    to end on hardware after calibration: 50s focused, 35s distracted, 59% ratio in
    Neon, from a button press with no browser running.
2026-08-19 Move the vision tier onto a cable, and the hub link onto the radio
    The camera streamed MJPEG over WiFi. Measured from the host over one 40s
    capture: 615 ms median inter-frame gap, 2671 ms p95, 6331 ms worst, 2% of
    frames inside 150 ms, on a link carrying 0.12 Mbps. The same board over USB
    does 19.6 fps at 210 KB/s. The sensor was never the constraint.
    Frame rate is the smaller reason. This instrument has to be demonstrated on a
    network nobody controls, and the wireless path cannot survive that trip:
    credentials are compile-time with no provisioning path, WPA2-Enterprise cannot
    be joined by WiFi.begin(ssid, pass), a captive portal cannot be answered by a
    device with no browser, and client is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
2026-08-19 Stop chasing a network that is not there, so the radio link holds
    Away from a known access point both boards retry Wi-Fi indefinitely — the hub
    through netService's backoff, the camera every ten seconds with none. Each
    attempt makes the STA scan, which moves the radio off channel and drops ESP-NOW
    traffic in both directions while it does. The two boards scan on independent
    schedules, so the hub-to-camera link degrades exactly where it is the only link
    there is.
    After six consecutive failures each board stops retrying, disconnects the STA
    and pins the radio to the ESP-NOW channel. Six is long enough that a router
    rebooting at home does not trip it, short enough that a demonstration settles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
    [cadence_cam.ino, cadence_hub.ino, espnow_sync.h]
2026-08-19 Try a second network, so the instrument can leave the building
    An ESP32 cannot join WPA2-Enterprise or answer a captive portal, which is most
    of what a university runs. It can join a phone hotspot. Both boards now
    alternate between two configured networks on successive attempts, so bringing a
    hotspot is enough to have the hub post events and readings, pull the task list,
    and keep the dashboard live away from home.
    The USB frame path and the ESP-NOW hub link are unchanged and still work with no
    network at all; this only restores the features that genuinely need the backend.
    An empty WIFI_SSID2 collapses the behaviour to the single-network case, so an
    existing secrets.h keeps working.
    Co-Aut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
2026-08-19 Add a companion document explaining section 14 claim by claim
    Section 14 records a design change and the measurements behind it, but the
    report states conclusions rather than reasoning. This walks through every
    paragraph: what is being claimed, how the number was obtained, why the change
    was made, and what is most likely to be questioned.
    Includes the inference that was wrong along the way — attributing the frame
    rate deficit to the transport on the strength of one 98 ms minimum-gap sample —
    because which evidence carries a conclusion is part of the result.
2026-08-20 Keep the report documents out of the repository
    Word rewrites the entire file on every save, so each edit lands in history as a
    fresh ~450 KB binary blob that cannot be diffed, merged or reviewed. The two
    documents are deliverables rather than sources, and the material in them —
    measurements, protocol, the reasoning behind each change — is already carried by
    the READMEs and the code comments, where it can be read alongside what it
    describes.
    Both remain recoverable from history at 2d2b4c7. *.docx is now ignored, along
    with the lock files Word leaves beside an open document.
